qazaqstem/SumoBot/Scheme.png

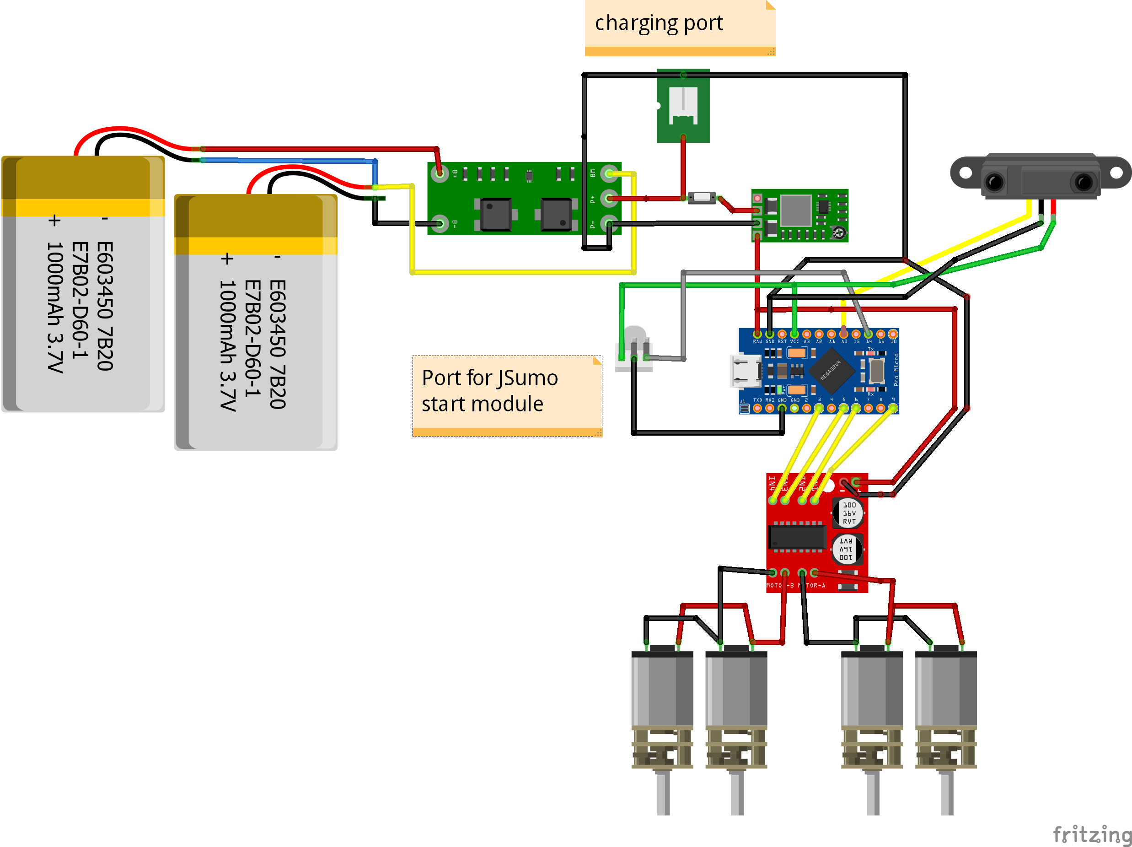
Scheme.png
