qazaqstem/SumoBot/PCB/SumoBot PCB siloute.dxf

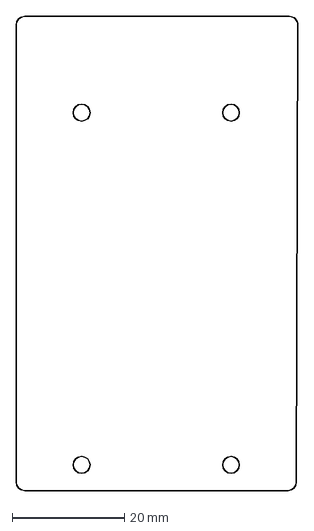
[picture p2: CAD file, 2024-05-27]
PCB/SumoBot PCB siloute.dxf
50.2 x 84.6 mm
