qazaqstem/SumoBot/STL/Silicone form cap for wheel x1.stl

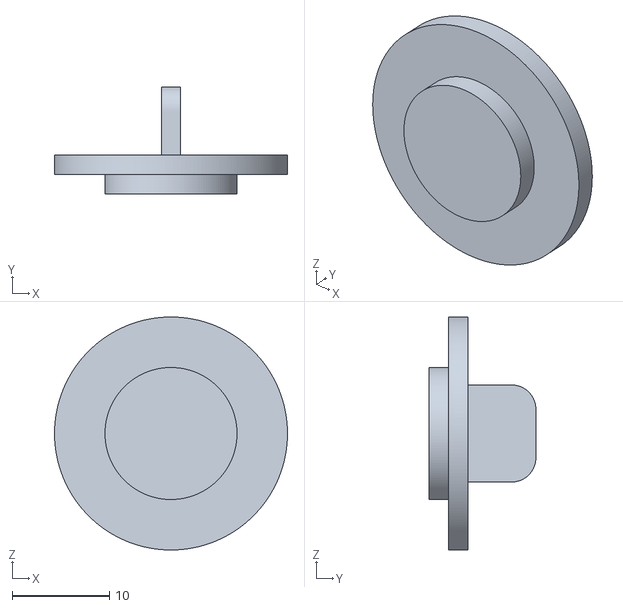
[picture p3: CAD file, 2024-05-27]
STL/Silicone form cap for wheel x1.stl
24.0 x 11.0 x 24.0
