qazaqstem/SumoBot/STL/Silicone form x2.stl

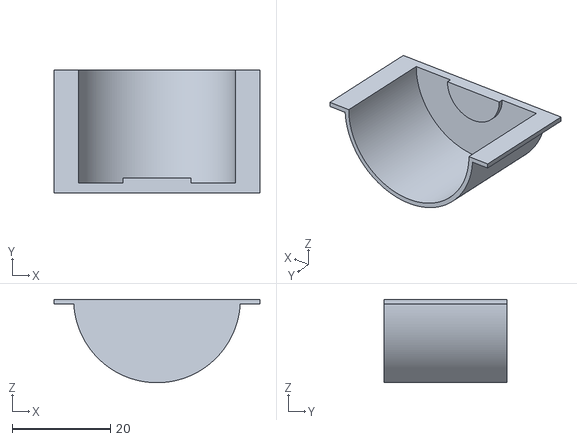
[picture p4: CAD file, 2024-05-27]
STL/Silicone form x2.stl
42.0 x 25.0 x 17.0
