qazaqstem/SumoBot/STL/Motor frame x4.stl

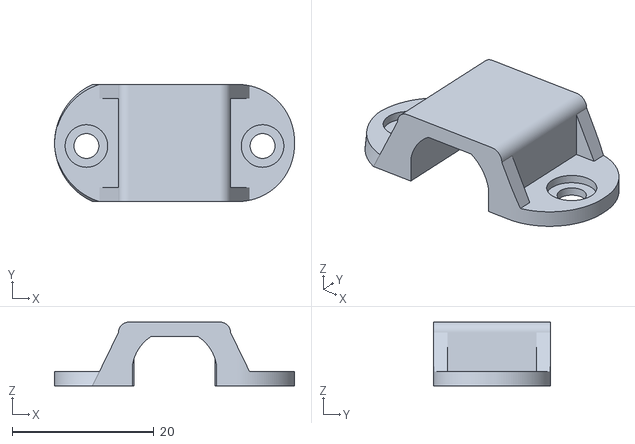
[picture p5: CAD file, 2024-05-27]
STL/Motor frame x4.stl
33.8 x 16.5 x 9.00
