qazaqstem/SumoBot/STL/PCB guard x1.stl

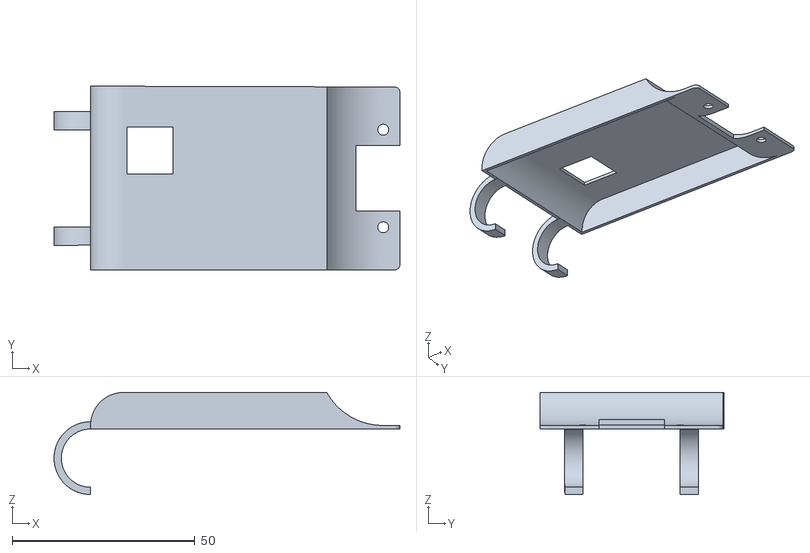
[picture p6: CAD file, 2024-05-27]
STL/PCB guard x1.stl
94.6 x 50.2 x 27.9
