qazaqstem/SumoBot/STL/Down base .stl

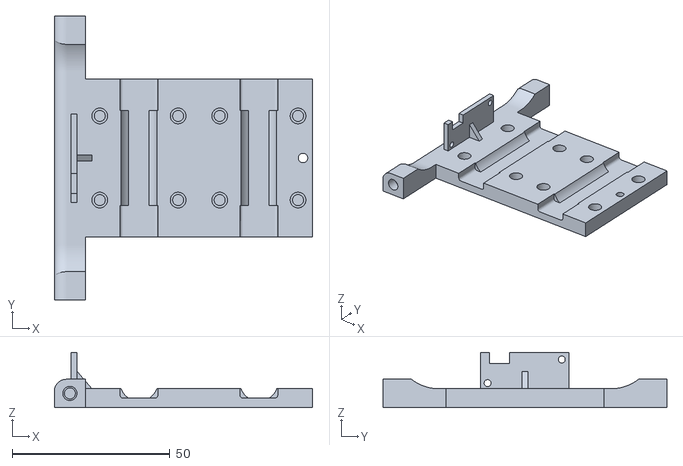
[picture p7: CAD file, 2024-05-27]
STL/Down base .stl
81.8 x 90.0 x 17.5
