qazaqstem/SumoBot/STL/Wheel disk x4.stl

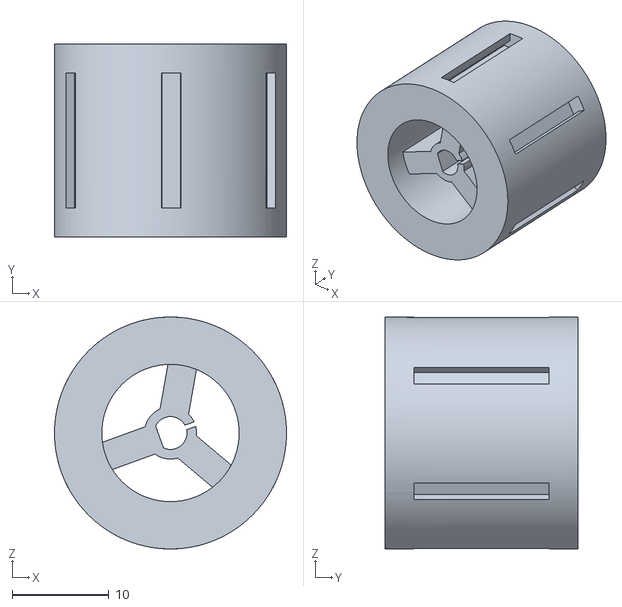
[picture p8: CAD file, 2024-05-27]
STL/Wheel disk x4.stl
24.0 x 20.0 x 24.0
