qazaqstem/SumoBot/STL/Rollback.stl

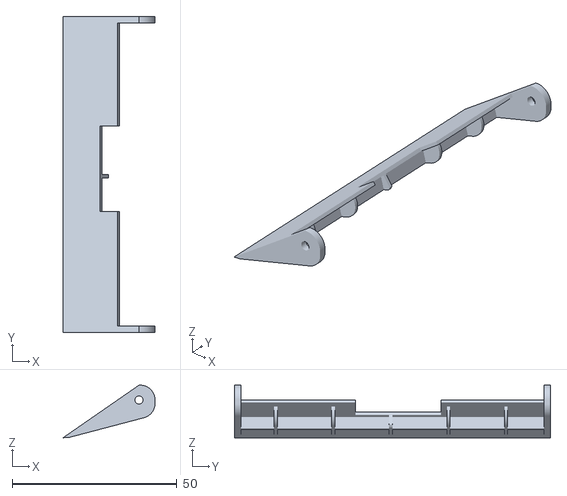
[picture p9: CAD file, 2024-05-27]
STL/Rollback.stl
28.0 x 96.0 x 16.0
