qazaqstem/SumoBot/PCB/Schematic_SumoBotPCB_2024-05-26 (1).pdf

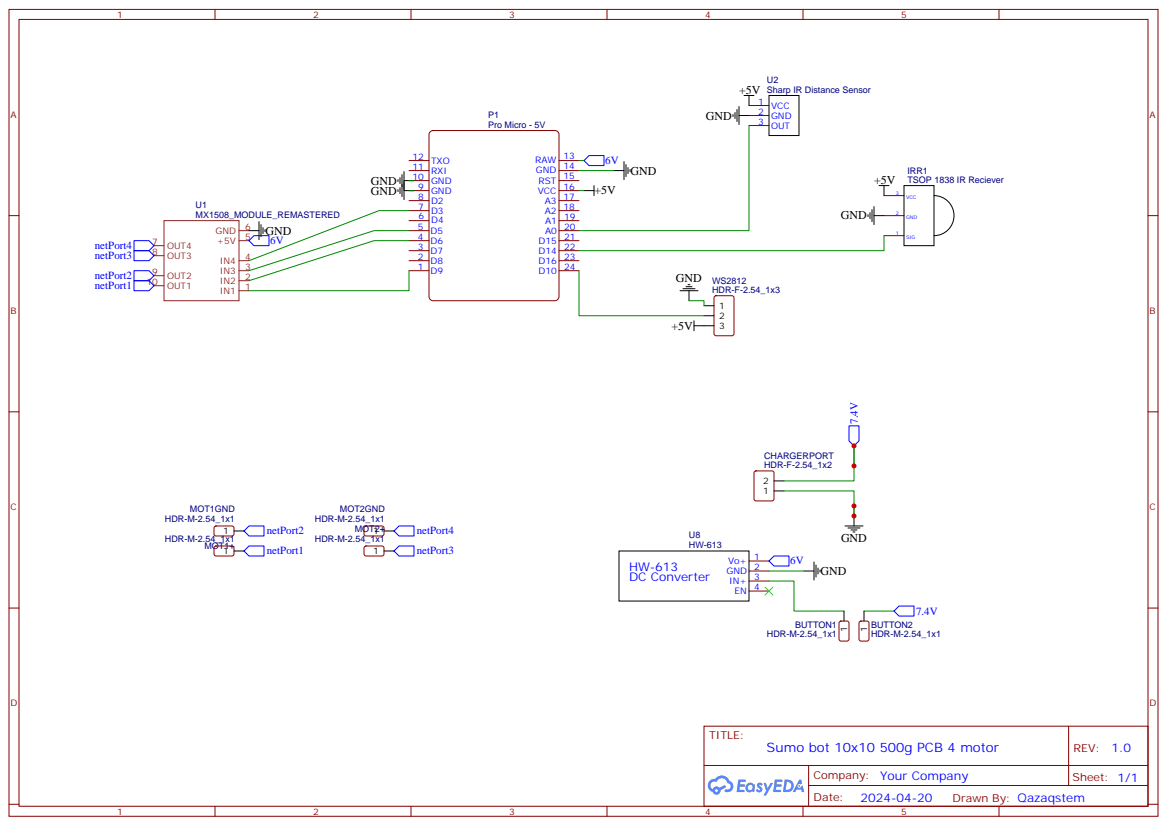
[picture p10: page 1]
